akamlibehsafe/gabinetecamera/04 Purchasing/MDF Export Para Cotar Marcenaria/Gemini_Generated_Image_02_mjg8u3mjg8u3mjg8.png

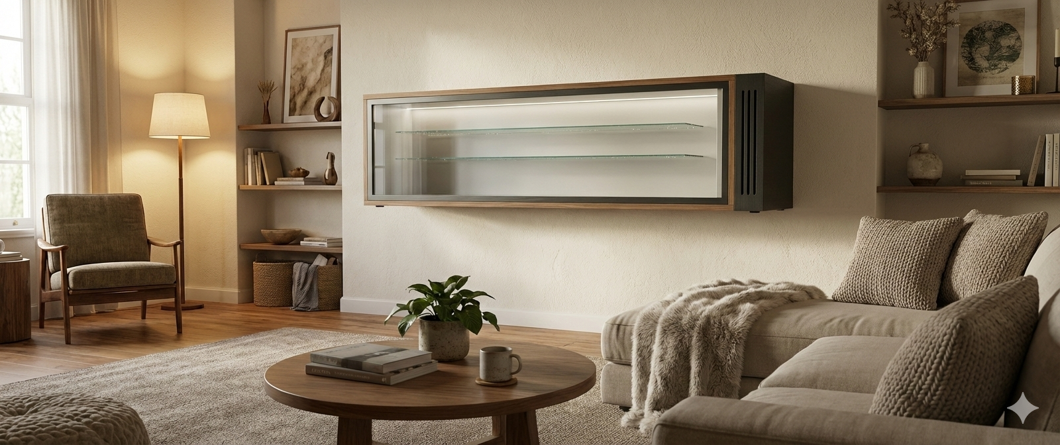
04 Purchasing/MDF Export Para Cotar Marcenaria/Gemini_Generated_Image_02_mjg8u3mjg8u3mjg8.png
