akamlibehsafe/gabinetecamera/04 Purchasing/MDF Export Para Cotar Marcenaria/Gemini_Generated_Image_06_x9az2px9az2px9az.png

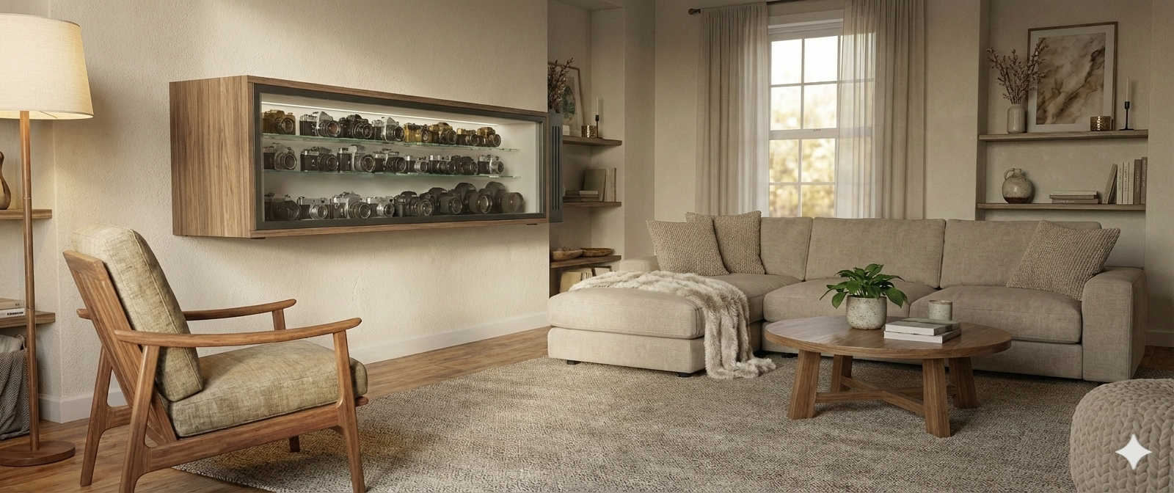
04 Purchasing/MDF Export Para Cotar Marcenaria/Gemini_Generated_Image_06_x9az2px9az2px9az.png
