akamlibehsafe/gabinetecamera/01 Specs IA/v0/05 Marcenaria.md

# Camera Dry Cabinet – Builder / Cabinet Maker Brief
**Documento exclusivo para marcenaria / fabricação do móvel**

Este documento define **apenas** os requisitos construtivos do gabinete.
Não inclui detalhes eletrônicos nem de controle.

---

## 1. Envelope Externo

- Dimensões externas finais:
  - **Largura:** 2200 mm
  - **Profundidade:** 300 mm
  - **Altura:** 600 mm
- Gabinete fixado na parede
- Orientação horizontal
- Estilo mobiliário (sala de estar)

---

## 2. Materiais

### Painéis Externos
- MDF padrão **18 mm**
- Acabamento:
  - Lâmina natural de madeira ou
  - Acabamento amadeirado de alta qualidade
- Tom escuro (compatível com outros móveis do ambiente)

### Caixa Interna (Volume Selado)
- **Ultra MDF**
- Pintura **PU automotiva**
- Superfícies internas lisas e fechadas
- Todas as juntas seladas com silicone

❗ Nenhuma superfície interna pode ficar com MDF cru exposto.

---

## 3. Estratégia de Dupla Camada

- Painéis externos = função estética
- Caixa interna = função técnica e de vedação
- Caixa interna deve ficar **recuada**, permitindo que:
  - a porta de vidro fique flush com os painéis externos
  - a gaxeta sele contra o Ultra MDF interno

---

## 4. Porta

- Porta única em vidro
- Abertura para cima
- Pistões hidráulicos (dimensionados para o peso do vidro)
- Moldura de alumínio
- **Gaxeta contínua de borracha ou silicone**

Vedação:
- A gaxeta deve encostar na face frontal da caixa interna
- Compressão uniforme ao fechar

---

## 5. Divisão Interna (Larguras Funcionais)

De esquerda para direita:

- Caixa técnica esquerda: **220 mm**
- Câmara das câmeras: **1760 mm**
- Caixa técnica direita: **220 mm**

Essas larguras são **funcionais** e devem ser respeitadas,
independentemente da espessura dos painéis.

---

## 6. Câmara das Câmeras

- Área principal de exposição
- Prateleira de vidro para duas fileiras de câmeras
- Deve existir uma **folga frontal de 3–5 cm** entre a prateleira e o vidro da porta
- Suportes da prateleira não devem bloquear laterais

---

## 7. Caixa Técnica Direita – Interfaces Críticas

### Wall B (parede estrutural interna)
- Separa a câmara das câmeras da câmara quente
- Contém apenas a abertura para passagem da placa fria
- Abertura deve permitir:
  - encaixe justo da placa
  - vedação com espuma
- **Não deve suportar peso ou esforço mecânico**

---

### Wall A (parede cosmética)
- Parede secundária, recuada **25–35 mm** em relação à Wall B
- Função estética e de ocultação
- Deve conter uma fenda vertical:
  - largura típica: **10–15 mm**
  - altura livre (a critério estético)
- A fenda NÃO precisa ser grande (não é entrada principal de ar)

---

## 8. Ventilação da Câmara Quente (Lado Direito)

- Deve existir comunicação da câmara quente com o ambiente externo
- Preferência: fenda vertical no painel lateral direito
- Deve haver um **defletor interno (baffle)** para:
  - evitar linha de visão direta para o dissipador
  - melhorar estética
- Área livre suficiente para ventilação silenciosa

---

## 9. Acesso Técnico

### Caixa técnica direita
- Painel frontal removível
- Vedação quando fechado
- Acesso completo a:
  - dissipador
  - eletrônica
  - bandeja de evaporação

### Caixa técnica esquerda
- Preferencialmente mesmo conceito de acesso
- Espaço reservado para futura expansão

---

## 10. Estanqueidade

- A caixa interna deve ser tratada como volume estanque
- Silicone em todas as juntas internas
- Porta + gaxeta são elementos críticos
- Não prever aberturas desnecessárias na câmara das câmeras

---

## 11. Observações Importantes

- A marcenaria **não deve**:
  - apoiar peso do dissipador na parede
  - fixar componentes eletrônicos diretamente no MDF sem suporte
- Qualquer elemento que possa receber condensação deve ser:
  - metálico
  - ou protegido por pintura PU e vedação

---

**FIM DO DOCUMENTO**
