akamlibehsafe/gabinetecamera/01 Specs IA/v0/06 CHECKLIST Compras.md

# Checklist de Compra – Camera Dry Cabinet
Projeto: Gabinete Expositivo com Controle Ativo de Umidade (TEC)
Status do projeto: Pronto para execução

Use este checklist para organizar as compras no Mercado Livre, AliExpress
ou fornecedores locais. Marque conforme adquirir.

---

## 1️⃣ Alimentação Elétrica

☐ Fonte chaveada **12 V / 20 A** (metal, bivolt)  
   ⮑ Tipo LED / CFTV  
   ⮑ Mercado Livre / AliExpress  

☐ Chave geral DC (≥ 15 A @ 12 V)  

☐ Conversor DC-DC **LM2596** (12 V → 5 V) *(opcional / futuro)*  

---

## 2️⃣ Controle Primário (Obrigatório)

☐ **Controlador de umidade XH-M452** (12 V)  
☐ Sensor de umidade com fio (normalmente incluso)  

---

## 3️⃣ Integração Tuya (Monitoramento & Override)

### Monitoramento
☐ Sensor Tuya de temperatura / umidade (Wi-Fi ou Zigbee)  

### Override (recomendado)
☐ Relé Tuya **12 V DC**  
   ⮑ Alternativa: tomada/interruptor Wi-Fi Tuya (AC)  

---

## 4️⃣ Sistema Termoelétrico (Desumidificação)

☐ **TEC1-12706** (comprar **2 unidades**)  
   ⮑ 1 em uso + 1 reserva  

☐ Placa fria de **cobre** (~100 × 140 × 8 mm)  

☐ Espalhador térmico de **alumínio** (50 × 50 × 6 mm)  

☐ Pasta térmica de boa qualidade  

---

## 5️⃣ Dissipação de Calor (Crítico)

☐ **Noctua NH-U12S** (dissipador + fan)  

☐ **Noctua NF-A12x25 PWM – 120 mm** (fan adicional)  

☐ **Noctua NF-A9 PWM – 92 mm** (fan da placa fria)  

☐ Adaptadores de baixo ruído Noctua (NA-RC) *(opcional)*  

---

## 6️⃣ Segurança (Obrigatório)

☐ Termostato **NC 65–70 °C** (KSD9700 ou equivalente)  

☐ Fusíveis automotivos:
- ☐ 15 A (linha TEC)
- ☐ 3 A (linha controle)

☐ Porta-fusíveis automotivos  

---

## 7️⃣ Clamping & Mecânica do Stack Térmico

☐ Hastes roscadas **inox** (M4 ou M5) – 4 unidades  

☐ Molas de compressão (inox ou zincadas) – 4 unidades  

☐ Arruelas inox – 8 unidades  

☐ Porcas travantes (nylock) – 4 unidades  

☐ Suporte / prateleira metálica para apoiar o dissipador  

---

## 8️⃣ Condensado & Vedação

☐ Espuma vedante (foam tape) para placa fria  

☐ Silicone neutro (vedação interna)  

☐ Material para calha de condensado (alumínio ou plástico)  

☐ Bandeja de evaporação (metal ou plástico resistente ao calor)  

☐ Pavio ou manta absorvente para evaporação  

---

## 9️⃣ Cabeamento & Conectores

### Cabos
☐ Cabo **AWG 16** (TEC)  
☐ Cabo **AWG 20–22** (ventoinhas)  
☐ Cabo **AWG 24** (sensores)  

### Conectores
☐ **WAGO 221** (distribuição elétrica)  

☐ Conectores XT30 ou XT60 *(opcional – TEC)*  

☐ Conectores JST-XH *(opcional – sensores/ventoinhas)*  

☐ Termo-retrátil (vários diâmetros)  

---

## 🔟 Marcenaria (Referência – não eletrônica)

☐ MDF padrão 18 mm (painéis externos)  

☐ Ultra MDF (caixa interna)  

☐ Tinta **PU automotiva** (interior)  

☐ Gaxeta de borracha/silicone para porta  

☐ Pistões hidráulicos (porta de vidro)  

☐ Moldura de alumínio para porta  

☐ Vidro (porta frontal)  

☐ Prateleira de vidro  

---

## 1️⃣1️⃣ Extras / Reserva (Recomendado)

☐ TEC extra (já previsto acima)  

☐ Fusíveis extras (15 A e 3 A)  

☐ Sensor Tuya reserva  

☐ Pasta térmica extra  

---

## 1️⃣2️⃣ Antes de Comprar – Conferência Final

☐ Todos os documentos lidos (Master Spec, Wiring, BOM)  
☐ Arquitetura final confirmada  
☐ Espaço físico validado com a marcenaria  
☐ Estratégia de montagem definida  

---

**Checklist pronto – compras podem começar**
