akamlibehsafe/gabinetecamera/01 Specs IA/v0/07 CHECKLIST Compras ML e Ali.md

# 🛒 Checklist de Compra – Camera Dry Cabinet  
## Versão Mercado Livre 🇧🇷 / AliExpress 🇨🇳

Projeto: Gabinete Expositivo com Controle Ativo de Umidade (TEC)  
Arquitetura: Controle local com fio + Tuya (monitoramento / override)

---

## 1️⃣ Alimentação Elétrica

### Fonte 12 V / 20 A (OBRIGATÓRIO)

☐ Fonte chaveada 12V 20A metálica (bivolt)

🔎 Mercado Livre – buscar:
- "Fonte chaveada 12V 20A bivolt"
- "Fonte 12V 20A metálica LED"
- "Fonte 12V 20A CFTV"

🔎 AliExpress – buscar:
- "12V 20A switching power supply metal case"

✔ Deve ser metálica  
✔ Ter furação de ventilação  
✔ Entrada AC 110–220 V  
⚠️ Evitar fontes seladas de plástico

---

☐ Chave geral DC (≥15 A)

🔎 Mercado Livre:
- "Chave liga desliga 12V 20A"
- "Interruptor DC 20A"

---

☐ Conversor DC-DC LM2596 (opcional)

🔎 Mercado Livre / AliExpress:
- "Conversor DC DC LM2596 12V 5V"

---

## 2️⃣ Controle Primário (LOCAL – OBRIGATÓRIO)

☐ Controlador de umidade **XH-M452** (12 V)

🔎 Mercado Livre:
- "Controlador de umidade XH-M452"
- "Controlador umidade digital XH-M452"

🔎 AliExpress:
- "XH-M452 humidity controller"

✔ Confirmar que:
- Funciona em **12 V**
- Tem **sensor com fio incluído**
- Ajuste de histerese

---

## 3️⃣ Integração Tuya

### Monitoramento (recomendado)

☐ Sensor Tuya temperatura / umidade (Wi-Fi ou Zigbee)

🔎 Mercado Livre:
- "Sensor temperatura umidade Tuya WiFi"
- "Sensor umidade Tuya Smart Life"

Marcas comuns:
- Moes
- Zemismart
- Positivo Casa Inteligente

🔎 AliExpress:
- "Tuya WiFi temperature humidity sensor"
- "Tuya Zigbee temperature humidity sensor"

⚠️ Não usar como controle primário

---

### Override manual (recomendado)

☐ Relé Tuya 12 V DC

🔎 Mercado Livre:
- "Relé WiFi Tuya 12V"
- "Módulo relé Tuya 12V"

🔎 AliExpress:
- "Tuya 12V relay module"

✔ Usado apenas para:
- desligar TEC remotamente
- modo manutenção

---

### Alternativa simples (AC)

☐ Tomada ou interruptor Wi-Fi Tuya (AC)

🔎 Mercado Livre:
- "Tomada WiFi Tuya 16A"
- "Interruptor WiFi Tuya"

⚠️ Desliga o sistema inteiro (inclusive ventoinhas)

---

## 4️⃣ Sistema Termoelétrico

☐ Módulo Peltier **TEC1-12706** (comprar 2)

🔎 Mercado Livre / AliExpress:
- "Peltier TEC1-12706"
- "Módulo termoelétrico TEC1-12706"

✔ Comprar 2 unidades (1 reserva)

---

☐ Placa fria de cobre (~100×140×8 mm)

🔎 Mercado Livre:
- "Placa de cobre 8mm"
- "Chapa cobre usinada"

🔎 AliExpress:
- "Copper cold plate 8mm"

⚠️ Preferir superfície lisa (sem aletas)

---

☐ Espalhador térmico de alumínio (50×50×6 mm)

🔎 Mercado Livre / AliExpress:
- "Placa alumínio 6mm"
- "Aluminum heat spreader 50x50"

---

☐ Pasta térmica de boa qualidade

🔎 Mercado Livre:
- "Pasta térmica Arctic"
- "Pasta térmica Cooler Master"

---

## 5️⃣ Dissipação de Calor (CRÍTICO)

☐ **Noctua NH-U12S**

🔎 Mercado Livre:
- "Noctua NH-U12S"

🔎 AliExpress:
- "Noctua NH-U12S original"

⚠️ Evitar clones  
✔ Conferir embalagem original Noctua

---

☐ Ventoinha 120 mm – **Noctua NF-A12x25 PWM** (1 extra)

🔎 Mercado Livre:
- "Noctua NF-A12x25"

---

☐ Ventoinha 92 mm – **Noctua NF-A9 PWM**

🔎 Mercado Livre:
- "Noctua NF-A9 PWM"

---

## 6️⃣ Segurança (OBRIGATÓRIO)

☐ Termostato NC 65–70 °C – **KSD9700**

🔎 Mercado Livre:
- "KSD9700 70C NC"
- "Protetor térmico 70 graus normalmente fechado"

---

☐ Fusíveis automotivos tipo lâmina

🔎 Mercado Livre:
- "Fusível lâmina 15A"
- "Fusível lâmina 3A"

☐ Porta-fusível automotivo

🔎 Mercado Livre:
- "Porta fusível automotivo"

---

## 7️⃣ Clamp & Mecânica

☐ Hastes roscadas inox M4 ou M5 (4x)

🔎 Mercado Livre:
- "Haste roscada inox M4"
- "Haste roscada inox M5"

---

☐ Molas de compressão (4x)

🔎 Mercado Livre:
- "Mola compressão inox"
- "Mola compressão aço"

---

☐ Arruelas inox + porcas nylock

🔎 Mercado Livre:
- "Arruela inox M4"
- "Porca travante inox"

---

☐ Suporte metálico / prateleira para dissipador

🔎 Mercado Livre:
- "Cantoneira metálica reforçada"
- "Suporte prateleira aço"

---

## 8️⃣ Condensado & Vedação

☐ Espuma vedante (foam tape)

🔎 Mercado Livre:
- "Fita espuma vedação"

---

☐ Silicone neutro

🔎 Mercado Livre:
- "Silicone neutro transparente"

---

☐ Material para calha (alumínio ou plástico)

🔎 Mercado Livre:
- "Perfil alumínio U"
- "Canaleta plástica"

---

☐ Bandeja de evaporação + pavio

🔎 Mercado Livre:
- "Bandeja alumínio"
- "Manta absorvente"
- "Cordão algodão pavio"

---

## 9️⃣ Cabos & Conectores

### Cabos

☐ Cabo AWG 16 (TEC)

🔎 Mercado Livre:
- "Cabo AWG 16 flexível"

---

☐ Cabo AWG 20–22 (ventoinhas)

🔎 Mercado Livre:
- "Cabo AWG 20 flexível"

---

☐ Cabo AWG 24 (sensores)

🔎 Mercado Livre:
- "Cabo AWG 24"

---

### Conectores

☐ **WAGO 221**

🔎 Mercado Livre:
- "Conector WAGO 221"

---

☐ Conectores XT30 / XT60 (opcional)

🔎 Mercado Livre:
- "Conector XT30"
- "Conector XT60"

---

☐ Termo-retrátil

🔎 Mercado Livre:
- "Espaguete termo retrátil"

---

## 🔟 Conferência Final Antes da Compra

☐ Master Spec revisado  
☐ Wiring Spec revisado  
☐ BOM conferida  
☐ Espaço validado com marcenaria  
☐ Estratégia de montagem definida  

---

**Checklist adaptado para Mercado Livre / AliExpress – pronto para uso**
