akamlibehsafe/gabinetecamera/02 Modelo Sketchup/3D Renders/v3/01 Visão Geral CAD Gabinete com Rosahl.png

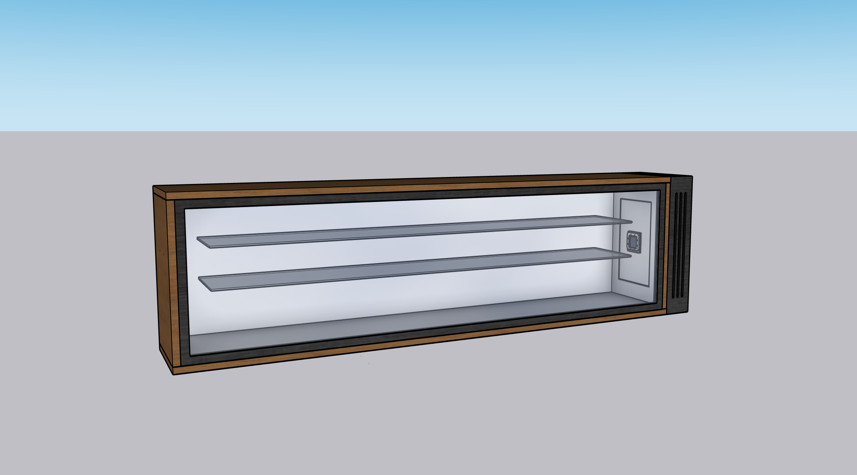
02 Modelo Sketchup/3D Renders/v3/01 Visão Geral CAD Gabinete com Rosahl.png
