akamlibehsafe/gabinetecamera/02 Modelo Sketchup/3D Renders/v3/02 Visão Detalhe CAD Gabinete com Rosahl.png

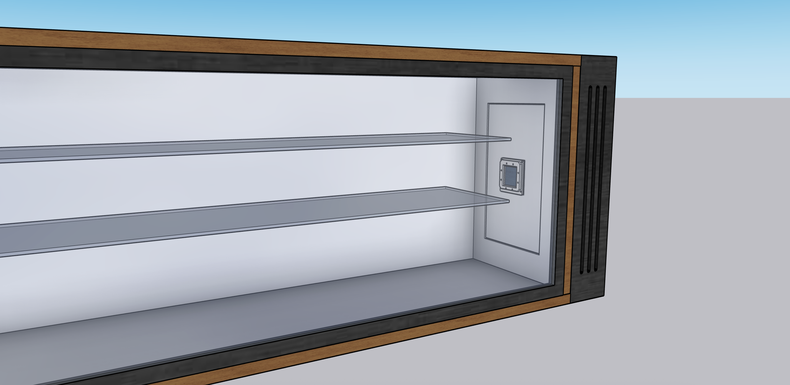
02 Modelo Sketchup/3D Renders/v3/02 Visão Detalhe CAD Gabinete com Rosahl.png
