akamlibehsafe/gabinetecamera/02 Modelo Sketchup/3D Renders/v3/03 Visão Detalhe CAD Gabinete com Rosahl pela Direita.png

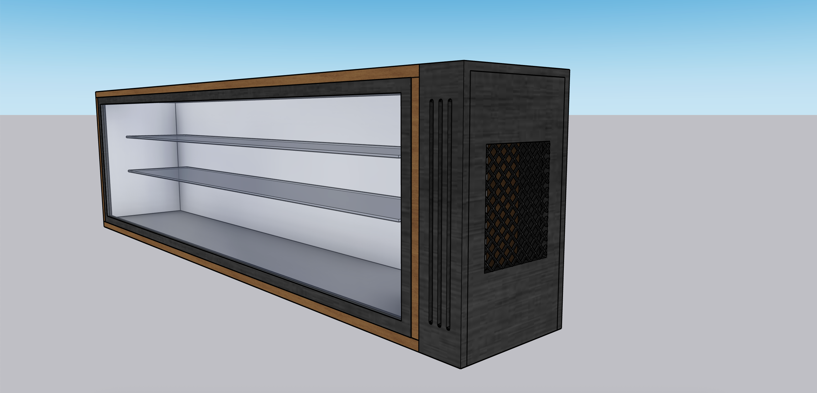
02 Modelo Sketchup/3D Renders/v3/03 Visão Detalhe CAD Gabinete com Rosahl pela Direita.png
