akamlibehsafe/gabinetecamera/02 Modelo Sketchup/3D Renders/v3/04 Visão Detalhe CAD Gabinete com Rosahl pela Direita Sem Cobertura.png

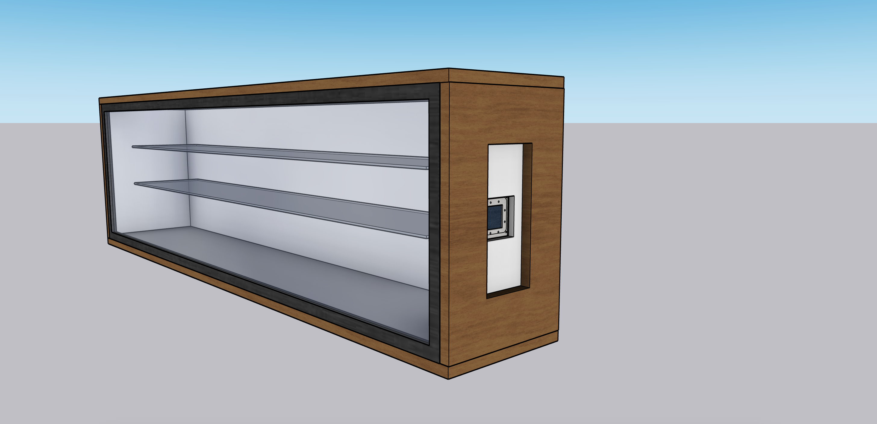
02 Modelo Sketchup/3D Renders/v3/04 Visão Detalhe CAD Gabinete com Rosahl pela Direita Sem Cobertura.png
