akamlibehsafe/gabinetecamera/02 Modelo Sketchup/3D Renders/v3/Gemini_Generated_Image_i2m67ji2m67ji2m6 (1).png

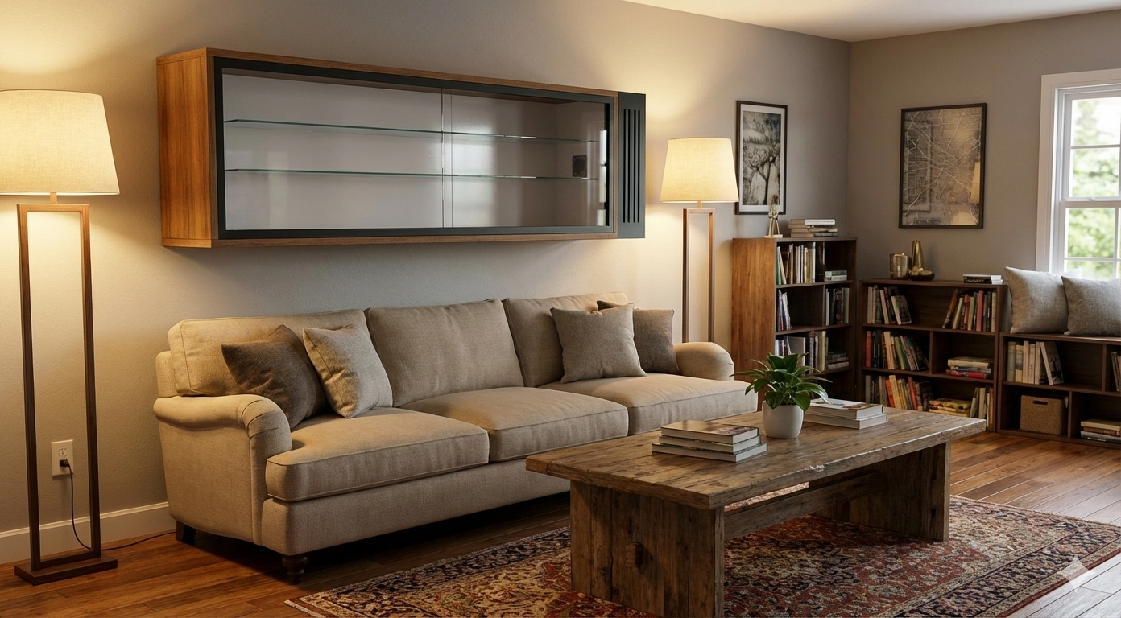
02 Modelo Sketchup/3D Renders/v3/Gemini_Generated_Image_i2m67ji2m67ji2m6 (1).png
