akamlibehsafe/gabinetecamera/02 Modelo Sketchup/3D Renders/v4 M-7J1R/Screenshot 2026-01-01 at 23.51.35 dimensions.png

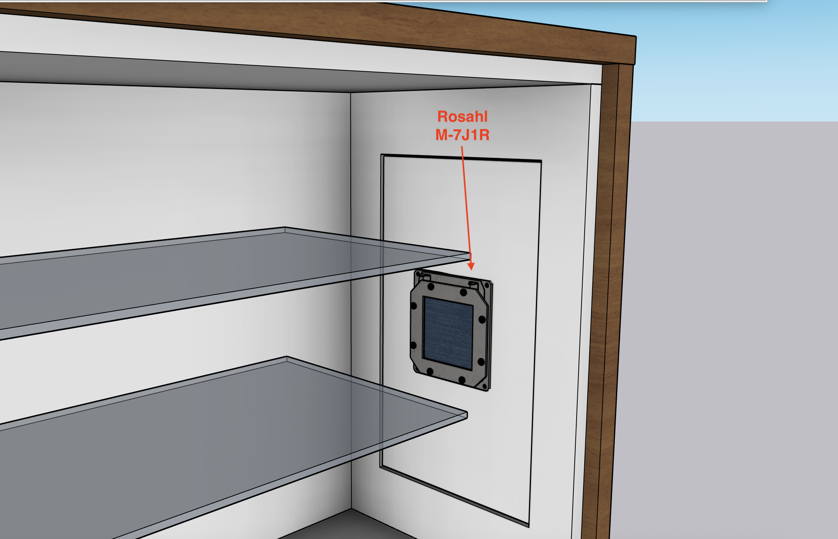
02 Modelo Sketchup/3D Renders/v4 M-7J1R/Screenshot 2026-01-01 at 23.51.35 dimensions.png
