akamlibehsafe/gabinetecamera/04 Purchasing/MDF Export Para Cotar Marcenaria/Gemini_Generated_Image_04_2l32h62l32h62l32.png

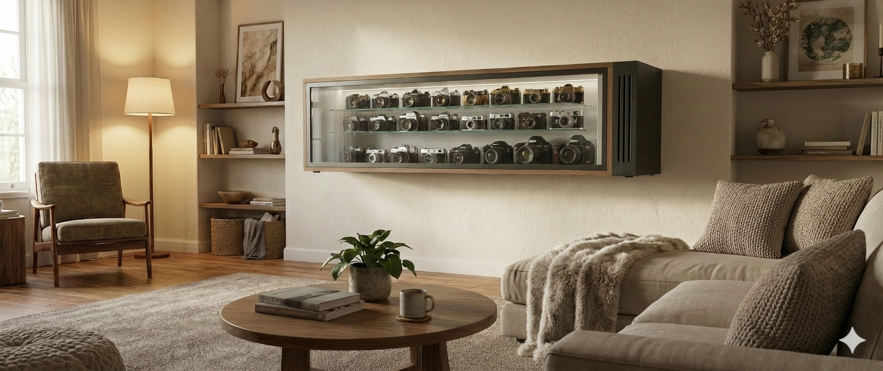
04 Purchasing/MDF Export Para Cotar Marcenaria/Gemini_Generated_Image_04_2l32h62l32h62l32.png
