akamlibehsafe/gabinetecamera/04 Purchasing/PowerUp Liquid Coller System.png

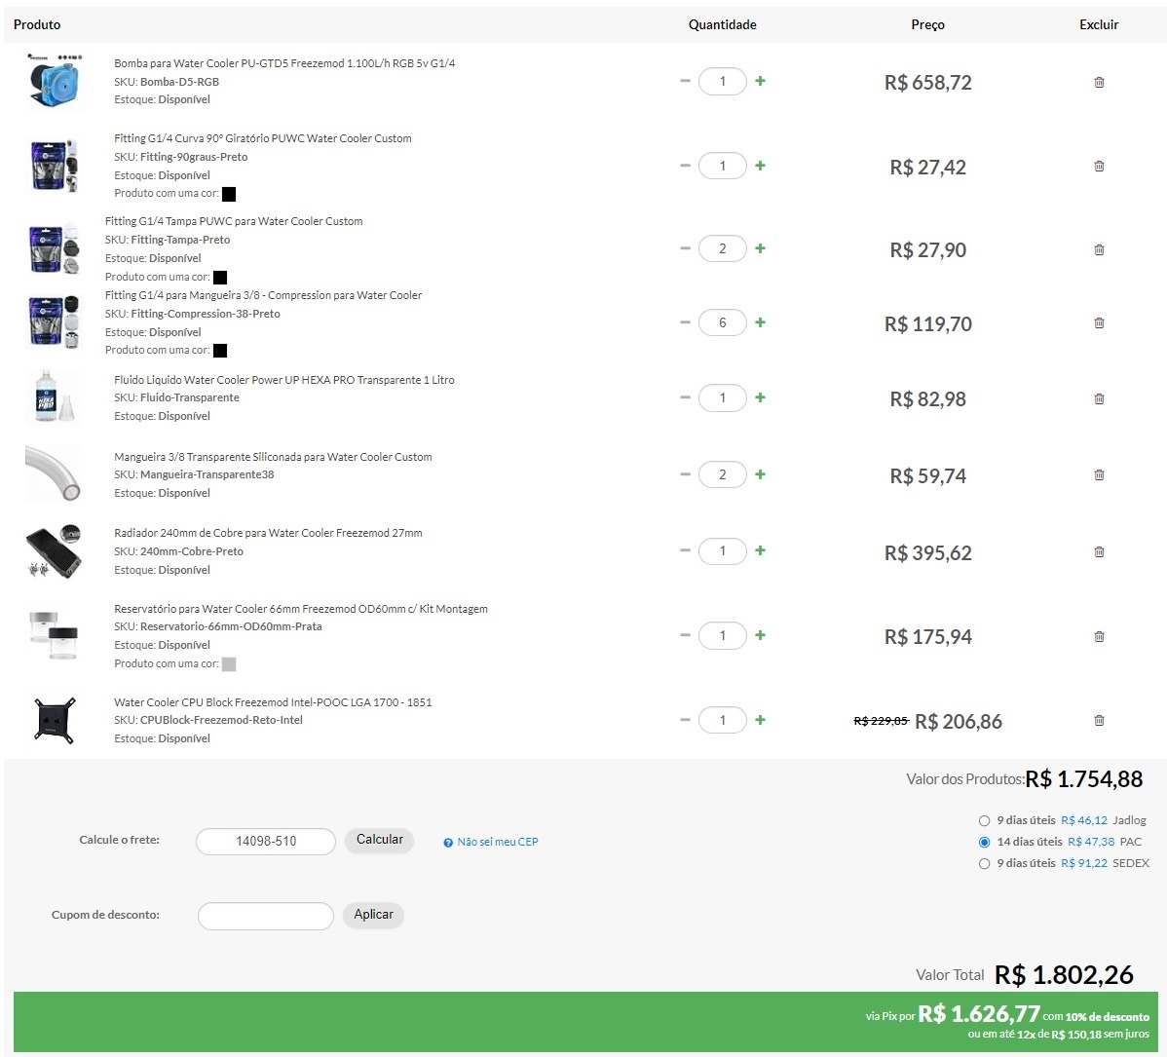
04 Purchasing/PowerUp Liquid Coller System.png
