akamlibehsafe/gabinetecamera/04 Purchasing/Rosahl/_Contato.png

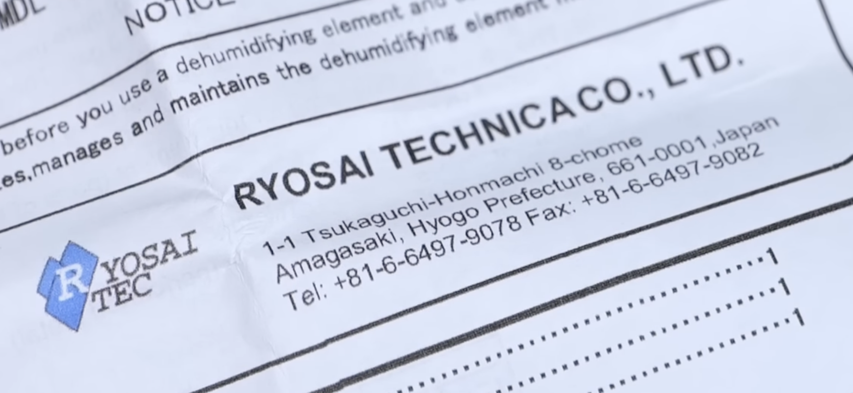
04 Purchasing/Rosahl/_Contato.png
