akamlibehsafe/gabinetecamera/03 Stand 3D Print/Camera+Stand.3mf

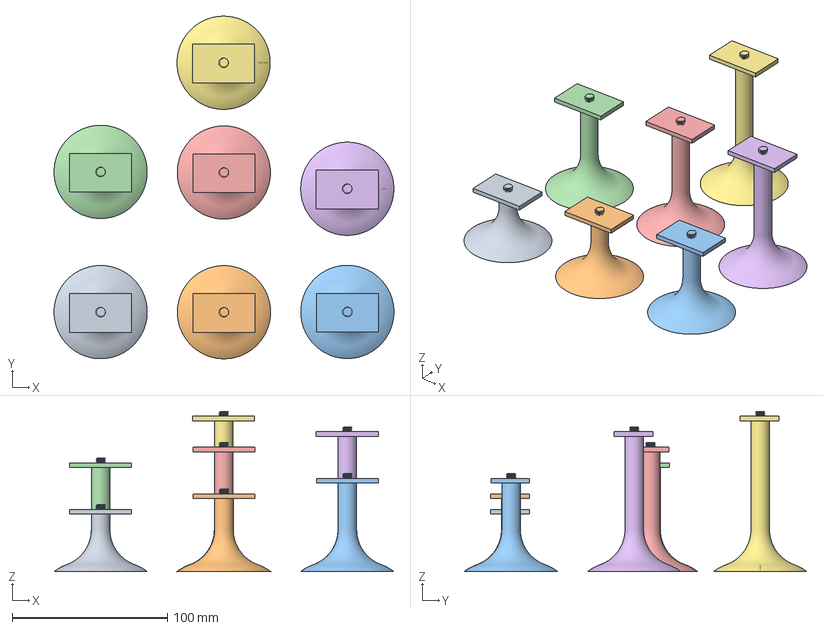
[picture p17: CAD file, 2025-12-21]
03 Stand 3D Print/Camera+Stand.3mf
218.8 x 220.5 x 103.0 mm
40mm
50mm
60mm
70mm
80mm
90mm
100mm
