akamlibehsafe/gabinetecamera/04 Purchasing/Rosahl/Modelos 3D/M-7J1R.stp

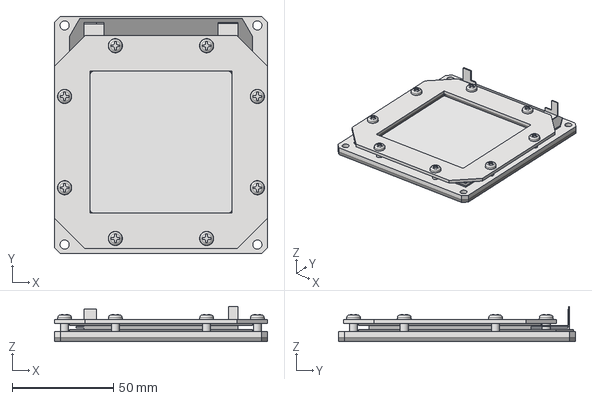
[picture p18: CAD file, 2026-01-02]
04 Purchasing/Rosahl/Modelos 3D/M-7J1R.stp
105.0 x 117.0 x 17.3 mm
