akamlibehsafe/gabinetecamera/04 Purchasing/Rosahl/Modelos 3D/M-5J1R.stp

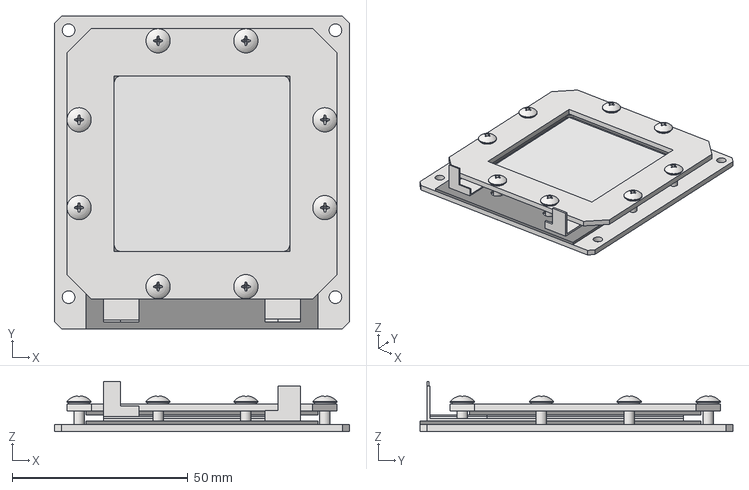
[picture p19: CAD file, 2026-01-02]
04 Purchasing/Rosahl/Modelos 3D/M-5J1R.stp
84.0 x 89.0 x 14.3 mm
