akamlibehsafe/gabinetecamera/(list of files, cad)

Other CAD files:
02 Modelo Sketchup/Components/Cameras/Hasselblad.skp
02 Modelo Sketchup/Components/Cameras/Nikon+F.skp
02 Modelo Sketchup/Components/Cameras/Nikon+FE2.skp
02 Modelo Sketchup/Components/Cameras/Olympus+XA.skp
02 Modelo Sketchup/Components/Cameras/Pentax K1000.skp
02 Modelo Sketchup/Components/Cameras/Pentax Spotmatic.skp
02 Modelo Sketchup/Components/Cameras/Rollei magic I.skp
02 Modelo Sketchup/Components/Cameras/Yashica D.skp
02 Modelo Sketchup/Components/Cameras/nt.skp
02 Modelo Sketchup/Components/Equipment/12V Power Supply 1 60W LED Power Supply.skp
02 Modelo Sketchup/Components/Equipment/240 Radiator 0 White 27mm Noctua Fans.skp
02 Modelo Sketchup/Components/Equipment/240 Radiator 3 27mm.skp
02 Modelo Sketchup/Components/Equipment/240 Radiator Noctua.skp
02 Modelo Sketchup/Components/Equipment/240 Radiator.skp
02 Modelo Sketchup/Components/Equipment/240 radiator 1 37mm.skp
02 Modelo Sketchup/Components/Equipment/240 radiator 2 Branco 27mm.skp
02 Modelo Sketchup/Components/Equipment/240 radiator 4 32mm.skp
02 Modelo Sketchup/Components/Equipment/CPU Block 1.skp
02 Modelo Sketchup/Components/Equipment/CPU Block.skp
02 Modelo Sketchup/Components/Equipment/Human Gi.skp
02 Modelo Sketchup/Components/Equipment/LED Profile.skp
02 Modelo Sketchup/Components/Equipment/Noctua 120mm.skp
02 Modelo Sketchup/Components/Equipment/Noctua NH-C14S Two Fan.skp
02 Modelo Sketchup/Components/Equipment/Noctua NH-U12S.skp
02 Modelo Sketchup/Components/Equipment/Noctua NH-U9S.skp
02 Modelo Sketchup/Components/Equipment/Pitbull.skp
02 Modelo Sketchup/Components/Equipment/Porta Closet.skp
02 Modelo Sketchup/Components/Equipment/Puxador Argola.skp
02 Modelo Sketchup/Components/Equipment/Puxador Concha.skp
02 Modelo Sketchup/Components/Equipment/Reservatorio 01.skp
02 Modelo Sketchup/Components/Equipment/Reservatorio 02.skp
02 Modelo Sketchup/Components/Equipment/Tuniq Tower 120 Universal CPU Cooler 120mm Cooling Fan and Heatsink.skp
02 Modelo Sketchup/Components/Equipment/Tuniq Tower 120 Universal CPU Cooler 120mm Cooling Fan and Heatsink~.skp
02 Modelo Sketchup/Components/Equipment/Wire Mesh 01.skp
02 Modelo Sketchup/Components/Equipment/Wire Mesh 02.skp
02 Modelo Sketchup/Components/Textures/Armario+Superior+basculante+porta+de+vidro.skp
02 Modelo Sketchup/Components/Textures/Black Aluminum Windows.skp
02 Modelo Sketchup/Components/Textures/Glass_Tiles.skp
02 Modelo Sketchup/Components/Textures/Metal_Tiles.skp
02 Modelo Sketchup/Components/Textures/Solid_Color_Tiles.skp
02 Modelo Sketchup/Components/Textures/Wood_Tiles.skp
02 Modelo Sketchup/Components/Textures/cso020+vidro.skp
02 Modelo Sketchup/Components/Textures/modulo+porta+basculante+de+vidro+puxador+gola.skp
04 Purchasing/Rosahl/Modelos 3D/M-7J1R.stl
