akamlibehsafe/gabinetecamera/01 Specs IA/v1 MVP/wiring.pdf

# TEC Dehumidifier MVP — Wiring Schematic (Printable)

Platform: XD-6038 (2× TEC1-12710) • Supply: 12 V DC • Controllers: XH-M452 (RH) + W1209 (Cold Plate Temp) • Switch: MOSFET ≥30 A

## 1) High-Current Power Path (TEC Power)

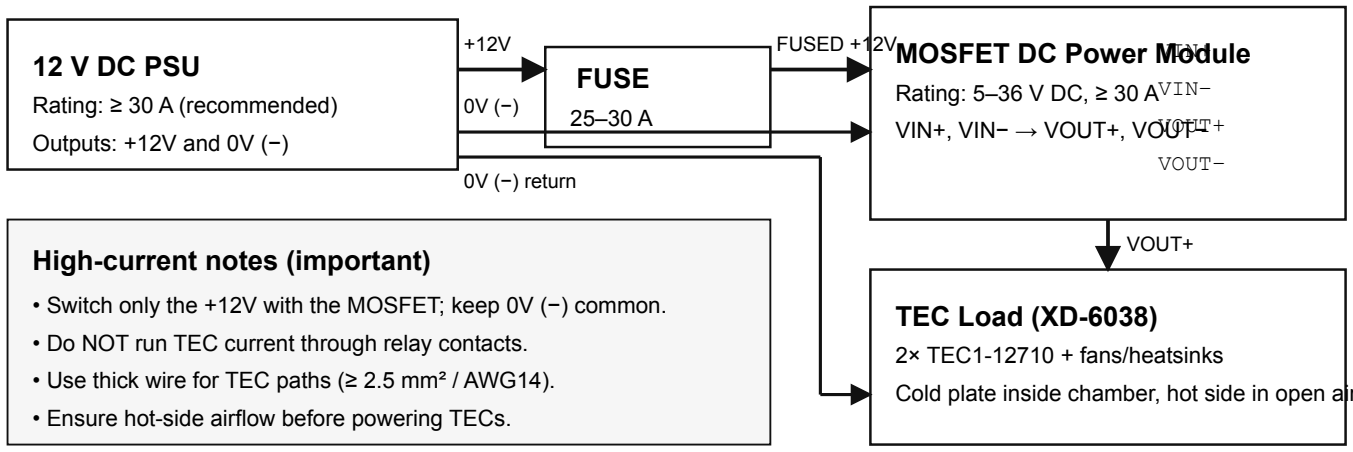
[picture p20: figure]
12 V DC PSU; Rating: ≥ 30 A (recommended); Outputs: +12V and 0V (−); FUSE; MOSFET DC Power Module; Rating: 5–36 V DC, ≥ 30 A; VIN+, VIN− → VOUT+, VOUT−; TEC Load (XD-6038); 2× TEC1-12710 + fans/heatsinks; FUSED +12V; VOUT+; 0V (−) return; VIN+; VIN−; VOUT−; High-current notes (important)

Cold plate inside chamber, hot side in open air

- Switch only the +12V with the MOSFET; keep 0V (−) common.
- Do NOT run TEC current through relay contacts.
- Use thick wire for TEC paths (≥ 2.5 mm² / AWG14).
- Ensure hot-side airflow before powering TECs.

## 2) Low-Current Control Logic (Relay Chain)

Rule: TEC ENABLE = (RH above setpoint) AND (Cold plate temperature above limit)

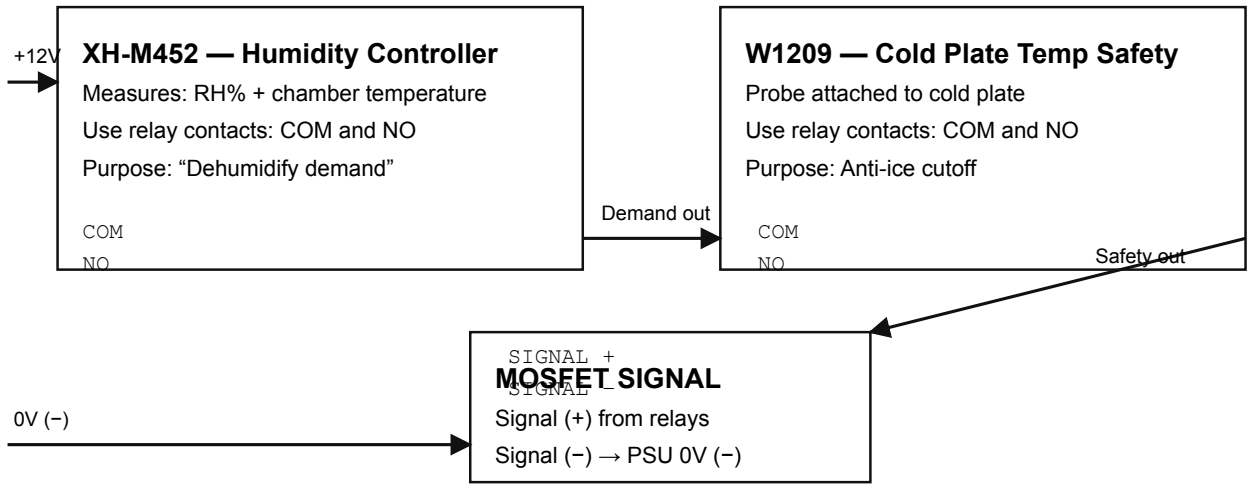
[picture p21: figure]
XH-M452 — Humidity Controller; Measures: RH% + chamber temperature; Use relay contacts: COM and NO; Purpose: “Dehumidify demand”; W1209 — Cold Plate Temp Safety; Probe attached to cold plate; Purpose: Anti-ice cutoff; MOSFET SIGNAL; Signal (+) from relays; Signal (−) → PSU 0V (−); COM NO; Demand out; Safety out; SIGNAL + SIGNAL −

Dashed line indicates low-current control wiring

## 3) Initial Settings (Safe Defaults)

### W1209 (cold plate)

Mode: Cooling
Setpoint: 8 °C
Hysteresis: 3 °C
If icing → raise cutoff to 10–12 °C

### XH-M452 (RH)

Target RH: 55%
Hysteresis: ~5%
Sensor mid-air, away from cold plate Lower setpoint after proving stability

Print tip: This is an A4 page at 1240×1754 px. You can paste this SVG into a file (e.g., wiring.svg) and print/export to PDF locally.
