akamlibehsafe/gabinetecamera/01 Specs IA/v1 MVP/wiring2.pdf

# TEC Dehumidifier MVP — Wiring (DaierTek Fuse Box + Fans)

Frozen parts: DaierTek Fuse Box (100A total, 30A/way, ATO/ATC) • PSU 12V ≥30–40A • MOSFET ≥30A • XH-M452 + W1209

Legend: Thick lines = high current (AWG12–14). Thin lines = low current (AWG18–20). Dashed = logic chain.

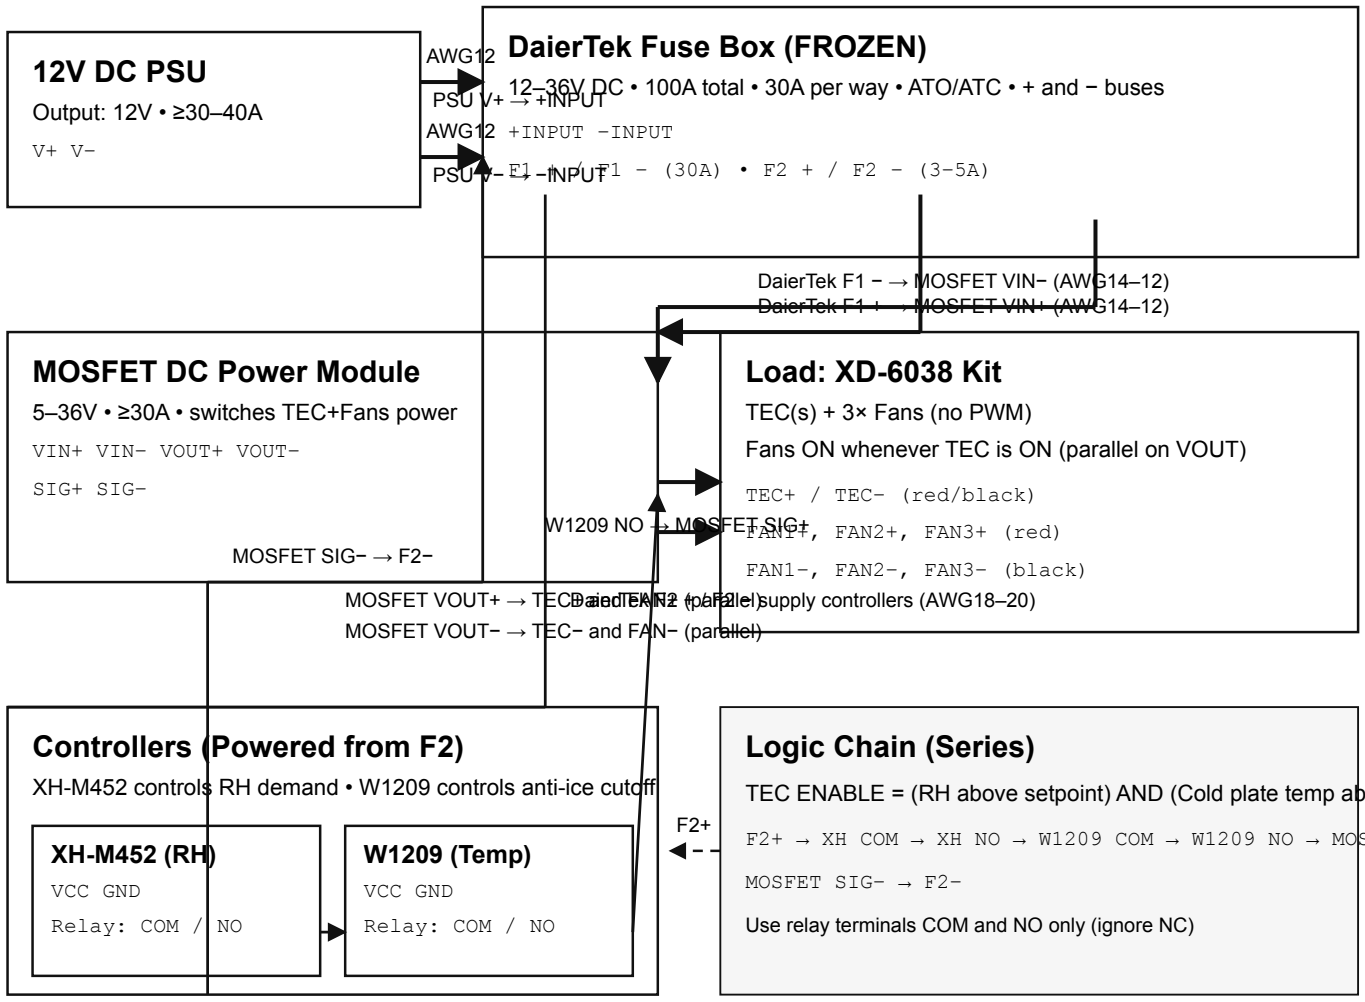
[picture p22: figure]
12V DC PSU; Output: 12V • ≥30–40A; DaierTek Fuse Box (FROZEN); +INPUT −INPUT; AWG12; PSU V+ → +INPUT AWG12; PSU V− → −INPUT; MOSFET DC Power Module; 5–36V • ≥30A • switches TEC+Fans power; VIN+ VIN− VOUT+ VOUT−; SIG+ SIG−; Load: XD-6038 Kit; TEC(s) + 3× Fans (no PWM); TEC+ / TEC− (red/black); FAN1+, FAN2+, FAN3+ (red); FAN1−, FAN2−, FAN3− (black); DaierTek F1 + → MOSFET VIN+ (AWG14–12); DaierTek F1 − → MOSFET VIN− (AWG14–12); MOSFET VOUT+ → TEC+ and FAN+ (parallel) MOSFET VOUT− → TEC− and FAN− (parallel); Controllers (Powered from F2); VCC GND; Relay: COM /; W1209 (Temp)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

12–36V DC • 100A total • 30A per way • ATO/ATC • + and − buses

Fans ON whenever TEC is ON (parallel on VOUT)

XH-M452 controls RH demand • W1209 controls anti-ice cutoff

DaierTek F2 + / F2 − supply controllers (AWG18–20)

TEC ENABLE = (RH above setpoint) AND (Cold plate temp abov

F2+ → XH COM → XH NO → W1209 COM → W1209 NO → MOSF

Use relay terminals COM and NO only (ignore NC)

## Build Notes (MVP)

- Install fuses: F1=30A (TEC+Fans), F2=3–5A (controllers). Keep other slots empty.
- 1-TEC mode: disconnect TEC2 + and − and insulate. 2-TEC mode: reconnect.
- Fans must be wired to MOSFET VOUT so they run whenever TEC runs.
- Keep high-current wires short; tighten all screw terminals firmly.

Print tip: Save as wiring svg and open in Preview/Inkscape to print or export PDF All “ground” references mean PSU negative (0V)

Print tip: Save as wiring.svg and open in Preview/Inkscape to print or export PDF. All ground references mean PSU negative (0V).
