akamlibehsafe/gabinetecamera/(commit log)

2025-12-21 Initial commit (without large SketchUp tiles files)
    [240 Radiator.skp, Armario+Superior+basculante+porta+de+vidro.skp, Black Aluminum Windows.skp, CPU Block.skp, Camera+Stand.3mf, Glass_Tiles.skp, Nikon+F.skp, Nikon+FE2.skp]
2025-12-22 Inicio Modulo TEC e Clamp
    [12V Power Supply 1 60W LED Power Supply.skp, 240 Radiator 0 White 27mm Noctua Fans.skp, 240 Radiator 3 27mm.skp, 240 Radiator Noctua.skp, 240 radiator 1 37mm.skp, 240 radiator 2 Branco 27mm.skp, 240 radiator 4 32mm.skp, CPU Block 1.skp]
2025-12-23 Inicio do V2 com NH-C14S
    [Noctua NH-C14S Two Fan.skp, Wire Mesh 01.skp, Wire Mesh 02.skp]
2025-12-26 Inclusão do Aparador e Render com Pitt
    [Hasselblad.skp, Pitbull.skp, Puxador Argola.skp, Puxador Concha.skp, Rollei magic I.skp, Yashica D.skp]
2025-12-27 Depois de Geometria Consertada e Ensinada
    [Human Gi.skp, Tuniq Tower 120 Universal CPU Cooler 120mm Cooling Fan and Heatsink.skp, Tuniq Tower 120 Universal CPU Cooler 120mm Cooling Fan and Heatsink~.skp]
2025-12-29 Pasta Marcenaria
    [Noctua NH-U12S.skp, Noctua NH-U9S.skp]
2026-01-02 V4 e Questions to Rosahl
    [M-5J1R.stp, M-7J1R.stl, M-7J1R.stp]
2026-01-07 Replace local folders
    [LED Profile.skp]
2026-01-08 Add large texture files via LFS (Wood_Tiles.skp and Metal_Tiles.skp)
    [Metal_Tiles.skp, Wood_Tiles.skp]
